rendyhd/movie-time/hardware/output/pdf/Movie_Time_NFC_Sticker_Template_A4.pdf

MOVIE TIME

# NFC sticker starting position

Print on A4 at Actual size / 100%. Do not use Fit to page.

1 Lay the CLOSED case with its BACK COVER facing up. The SPINE must be at the TOP, away from you.

2 Cut out the rectangle below along its solid border.
Put its bottom-left corner on the case's bottom-left corner.

3 Make a tiny hole at the target and mark through it.
Tape the sticker there. If reads fail, move it 5 mm at a time.

BACK COVER UP

SPINE

away from you

26 mm

31 mm

LEFT EDGE

BOTTOM EDGE

Nominal centre:

2.6 cm from the left edge

3.1 cm from the bottom edge

DVD and Blu-ray cases

use the same corner.

The pale circle shows a

25 mm sticker for scale.

Check the print scale with a ruler:

### 50 mm

If this line is not exactly 5 cm, print again at 100% scale.

Fix to the OUTSIDE of the back cover only after 5 reliable insertions.
