rendyhd/movie-time/hardware/output/final_version/preview/01_Spring_PETG_plate.png

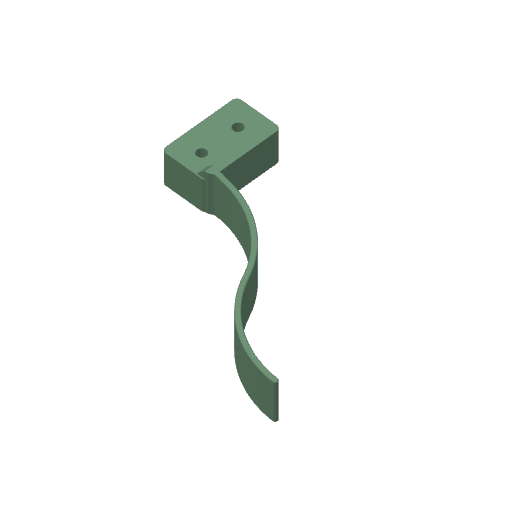
hardware/output/final_version/preview/01_Spring_PETG_plate.png
