rendyhd/movie-time/hardware/output/final_version/preview/02_Cute_Lid_PLA_plate.png

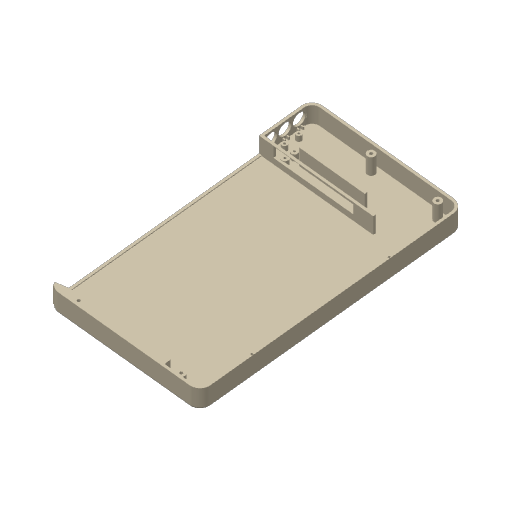
hardware/output/final_version/preview/02_Cute_Lid_PLA_plate.png
