rendyhd/movie-time/hardware/output/final_version/preview/03_Base_PLA_plate.png

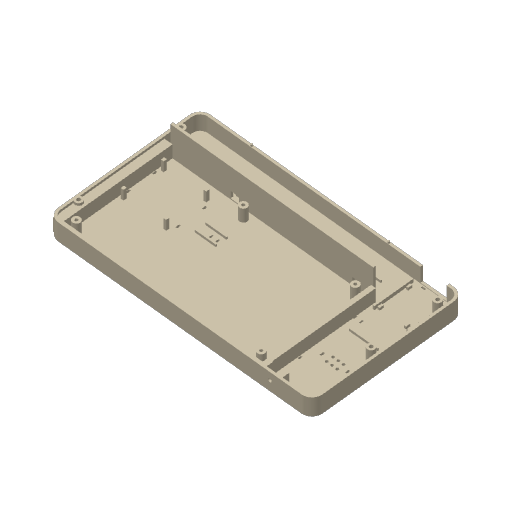
hardware/output/final_version/preview/03_Base_PLA_plate.png
