rendyhd/movie-time/hardware/output/final_version/preview/04_Deck_and_Hardware_PLA_plate.png

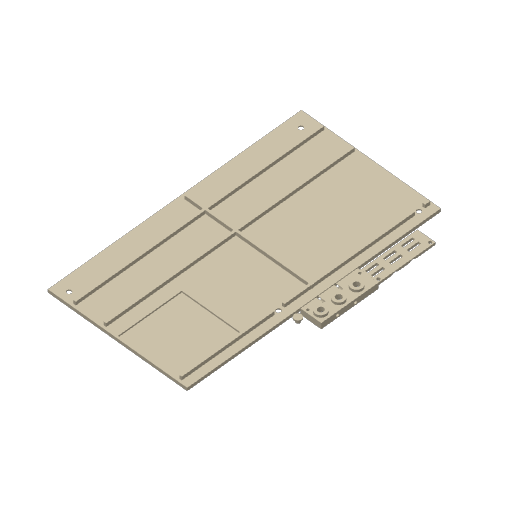
hardware/output/final_version/preview/04_Deck_and_Hardware_PLA_plate.png
