rendyhd/movie-time/hardware/output/final_version/preview/05_Buttons_PLA_plate.png

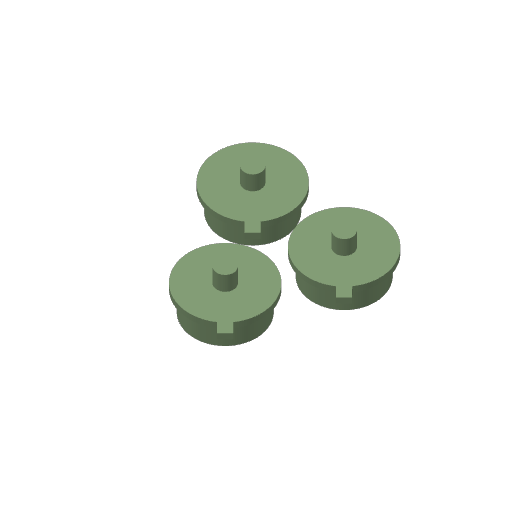
hardware/output/final_version/preview/05_Buttons_PLA_plate.png
