rendyhd/movie-time/hardware/output/final_version/preview/Button_and_case_fit_PLA_plate.png

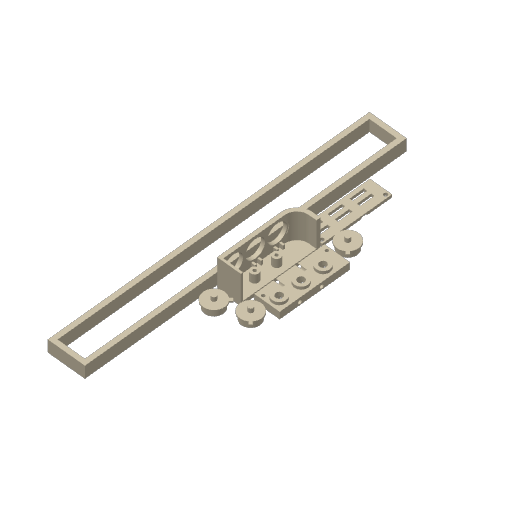
hardware/output/final_version/preview/Button_and_case_fit_PLA_plate.png
