rendyhd/movie-time/hardware/output/final_version/preview/reinforced_joint.png

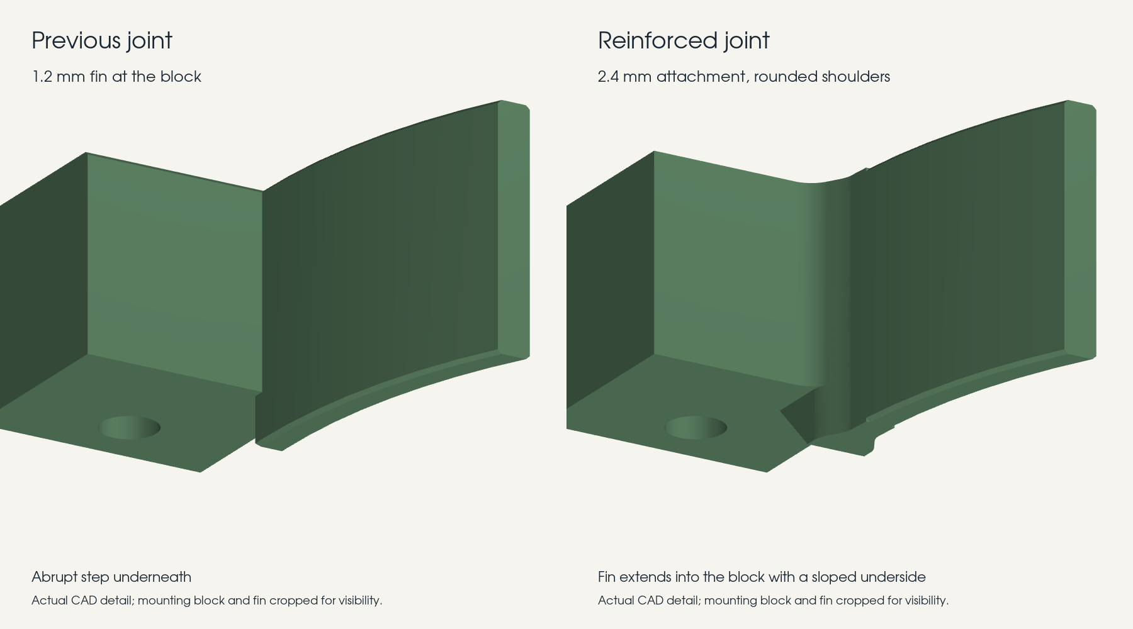
hardware/output/final_version/preview/reinforced_joint.png
