rendyhd/movie-time/hardware/output/final_version/step/Movie_Time_final_assembled.step

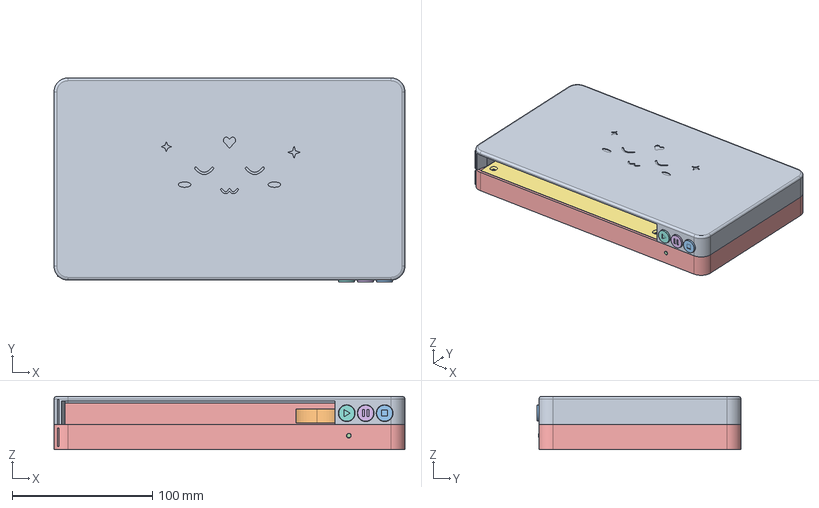
[picture p10: CAD file, 2026-10-13]
hardware/output/final_version/step/Movie_Time_final_assembled.step
250.0 x 145.4 x 38.0 mm
02_cute_lid_single_leaf
08_switch_retainer
06_button_stop
09_led_lens
01_base
05_button_pause
03_case_deck
04_button_play
07_switch_carrier
12_single_leaf_PETG
