rendyhd/movie-time/hardware/output/final_version/optional/Holder_Reach_Fix_PLA.3mf

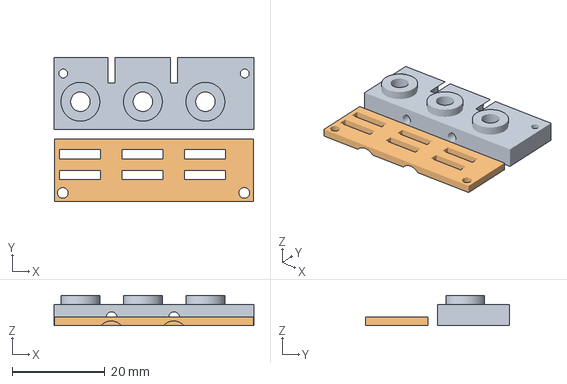
[picture p11: CAD file, 2026-10-13]
hardware/output/final_version/optional/Holder_Reach_Fix_PLA.3mf
43.2 x 31.2 x 6.50 mm
07_switch_carrier.stl
08_switch_retainer.stl
