rendyhd/movie-time/hardware/output/final_version/plates/05_Buttons_PLA.3mf

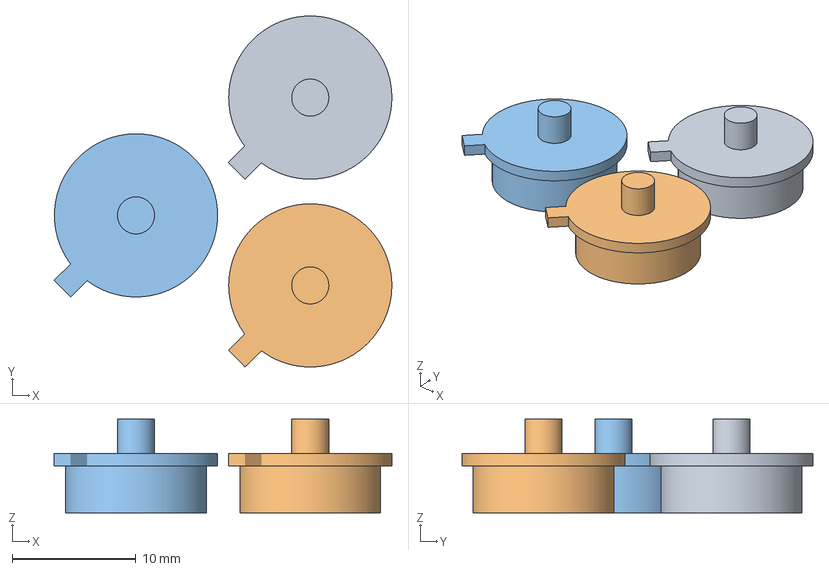
[picture p12: CAD file, 2026-10-13]
hardware/output/final_version/plates/05_Buttons_PLA.3mf
27.3 x 28.4 x 7.60 mm
04_button_play.stl
05_button_pause.stl
06_button_stop.stl
