rendyhd/movie-time/hardware/output/final_version/step/12_single_leaf_PETG.step

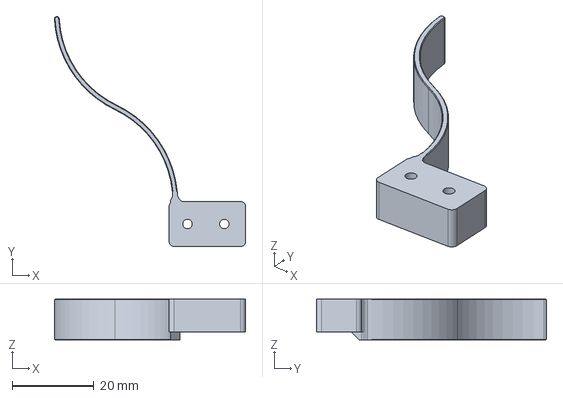
[picture p13: CAD file, 2026-10-13]
hardware/output/final_version/step/12_single_leaf_PETG.step
46.8 x 56.3 x 10.0 mm
