rendyhd/movie-time/hardware/output/final_version/optional/Button_and_case_fit_PLA.3mf

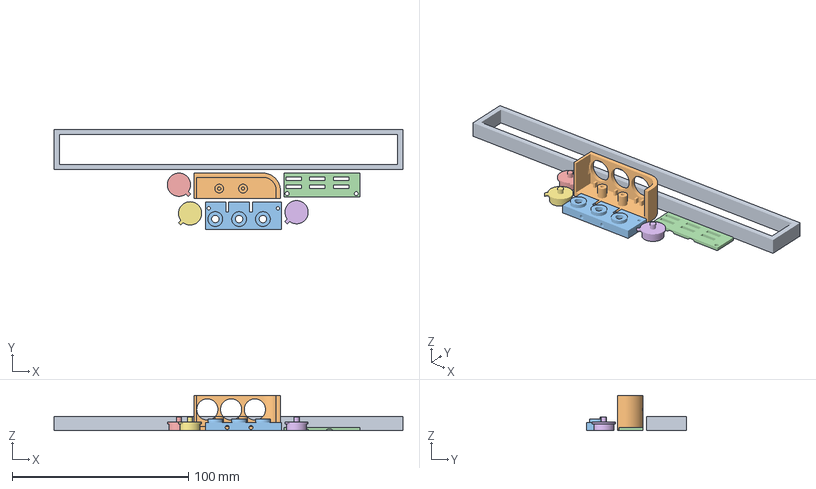
[picture p14: CAD file, 2026-10-13]
hardware/output/final_version/optional/Button_and_case_fit_PLA.3mf
198.0 x 56.9 x 20.0 mm
11_case_fit_test.stl
10_button_fit_test.stl
07_switch_carrier.stl
08_switch_retainer.stl
04_button_play.stl
05_button_pause.stl
06_button_stop.stl
