rendyhd/movie-time/hardware/output/final_version/step/06_button_stop.step

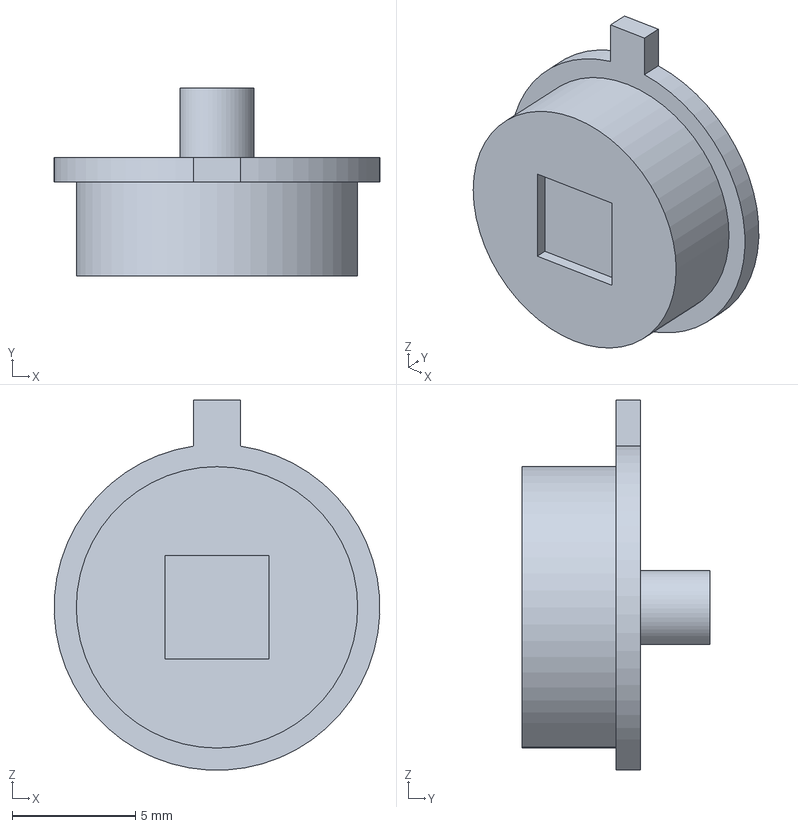
[picture p15: CAD file, 2026-10-13]
hardware/output/final_version/step/06_button_stop.step
13.2 x 7.60 x 15.0 mm
