rendyhd/movie-time/hardware/output/final_version/optional/Spring_test_fixture_PLA.3mf

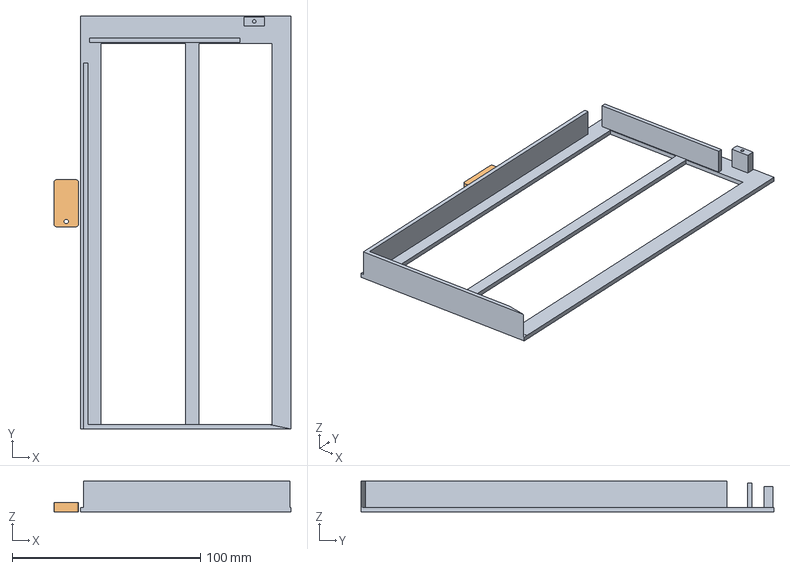
[picture p16: CAD file, 2026-10-13]
hardware/output/final_version/optional/Spring_test_fixture_PLA.3mf
126.0 x 219.4 x 16.4 mm
14_spring_test_bed.stl
15_spring_test_mount.stl
