rendyhd/movie-time/hardware/output/final_version/plates/02_Cute_Lid_PLA.3mf

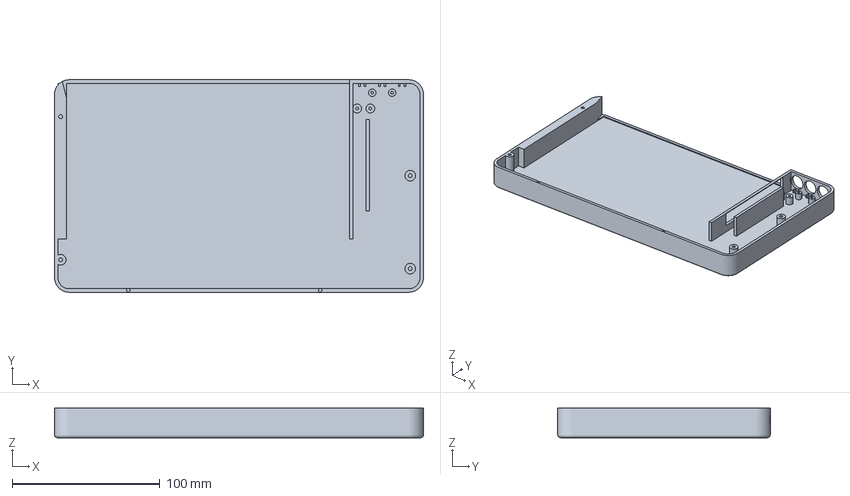
[picture p17: CAD file, 2026-10-13]
hardware/output/final_version/plates/02_Cute_Lid_PLA.3mf
250.0 x 144.0 x 20.0 mm
