rendyhd/movie-time/hardware/output/final_version/plates/03_Base_PLA.3mf

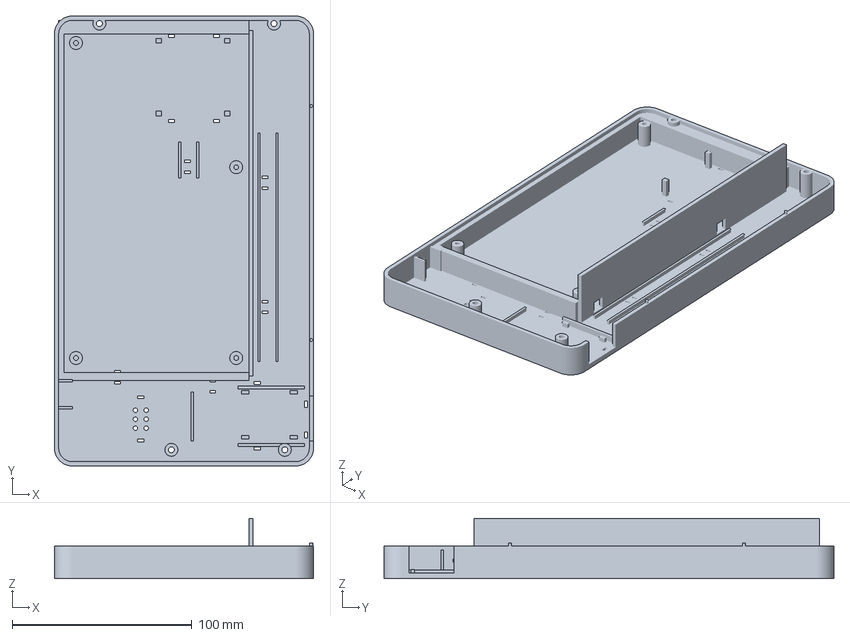
[picture p18: CAD file, 2026-10-13]
hardware/output/final_version/plates/03_Base_PLA.3mf
144.0 x 250.0 x 33.4 mm
