rendyhd/movie-time/hardware/output/final_version/plates/04_Deck_and_Hardware_PLA.3mf

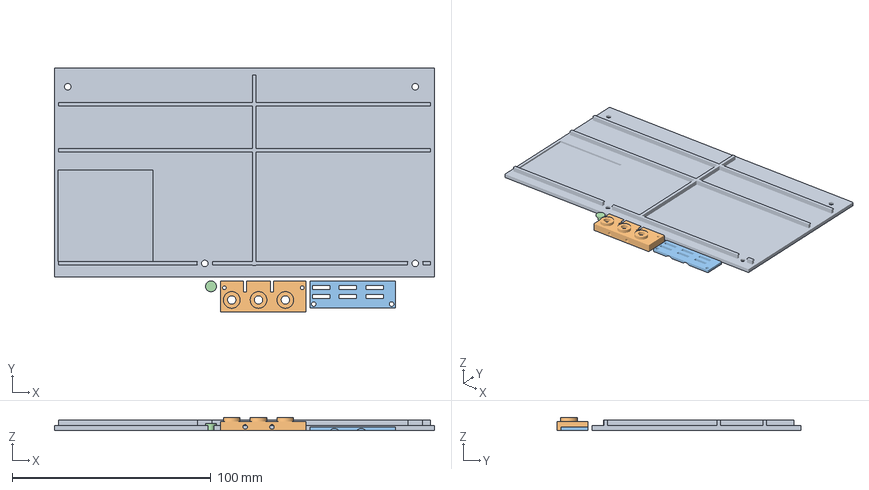
[picture p19: CAD file, 2026-10-13]
hardware/output/final_version/plates/04_Deck_and_Hardware_PLA.3mf
191.4 x 122.7 x 6.50 mm
03_case_deck.stl
07_switch_carrier.stl
08_switch_retainer.stl
09_led_lens.stl
