rendyhd/movie-time/hardware/output/final_version/step/03_case_deck.step

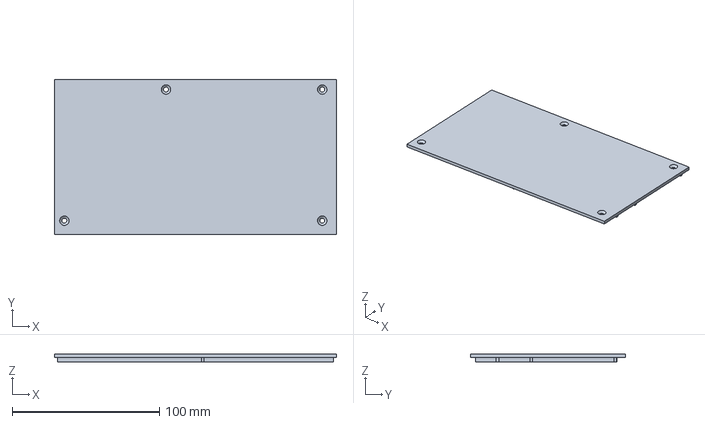
[picture p20: CAD file, 2026-10-13]
hardware/output/final_version/step/03_case_deck.step
191.4 x 105.1 x 5.20 mm
