rendyhd/movie-time/hardware/output/final_version/step/07_switch_carrier.step

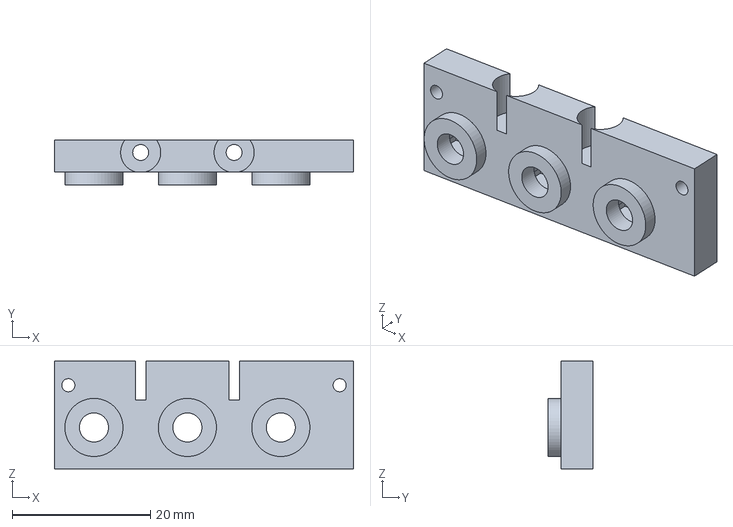
[picture p21: CAD file, 2026-10-13]
hardware/output/final_version/step/07_switch_carrier.step
43.2 x 6.50 x 15.6 mm
