rendyhd/movie-time/hardware/output/final_version/step/09_led_lens.step

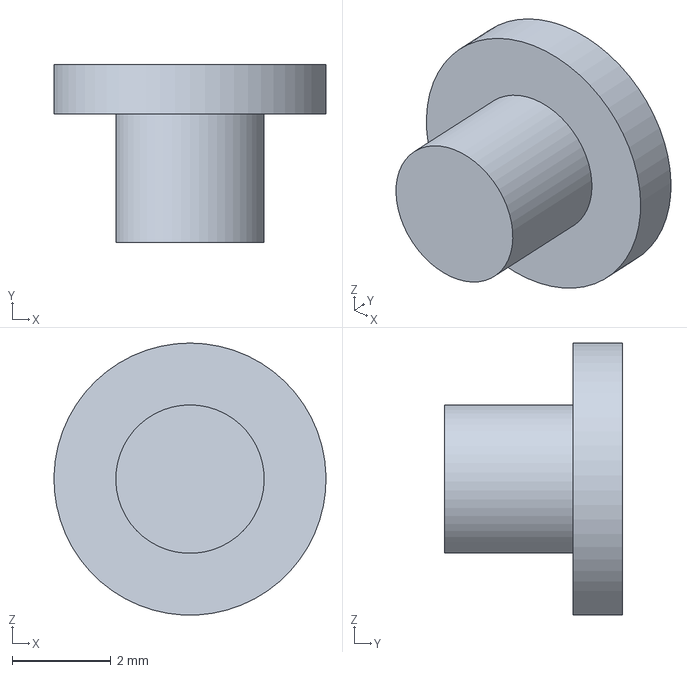
[picture p22: CAD file, 2026-10-13]
hardware/output/final_version/step/09_led_lens.step
5.50 x 3.60 x 5.50 mm
