rendyhd/movie-time/hardware/output/final_version/step/08_switch_retainer.step

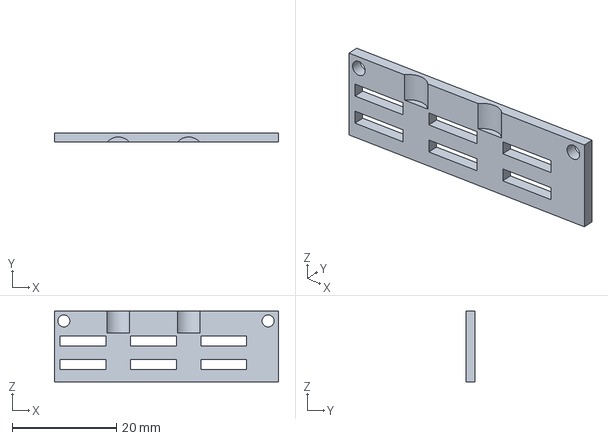
[picture p23: CAD file, 2026-10-13]
hardware/output/final_version/step/08_switch_retainer.step
43.0 x 1.80 x 13.6 mm
