rendyhd/movie-time/(list of files, cad)

Other CAD files:
hardware/output/final_version/plates/01_Spring_PETG.3mf
hardware/output/final_version/step/02_cute_lid_single_leaf.step
hardware/output/final_version/step/01_base.step
hardware/output/final_version/step/04_button_play.step
hardware/output/final_version/step/05_button_pause.step
hardware/output/final_version/stl/01_base.stl
hardware/output/final_version/stl/02_cute_lid_single_leaf.stl
hardware/output/final_version/stl/03_case_deck.stl
hardware/output/final_version/stl/04_button_play.stl
hardware/output/final_version/stl/05_button_pause.stl
hardware/output/final_version/stl/06_button_stop.stl
hardware/output/final_version/stl/07_switch_carrier.stl
hardware/output/final_version/stl/08_switch_retainer.stl
hardware/output/final_version/stl/09_led_lens.stl
hardware/output/final_version/stl/12_single_leaf_PETG.stl
