rendyhd/movie-time/hardware/output/final_version/preview/Holder_Reach_Fix_PLA_plate.png

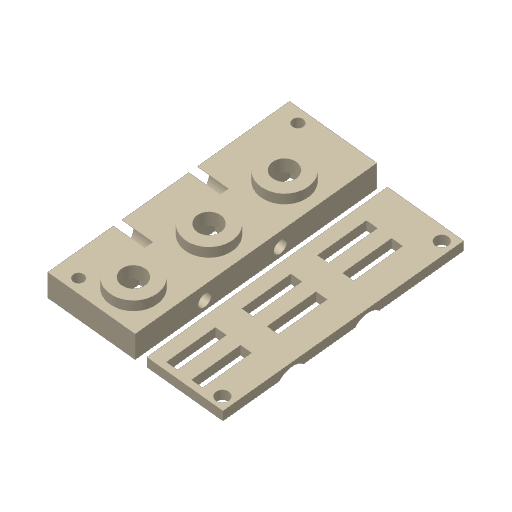
hardware/output/final_version/preview/Holder_Reach_Fix_PLA_plate.png
