rendyhd/movie-time/(commit log)

2026-10-13 Movie Time: NFC case player for Kodi
    An NFC player for a child's DVD/Blu-ray cases. Insert a case to start its
    movie in Kodi through Home Assistant; Play, Pause and Stop buttons work as
    labelled, and removing the case stops playback.
    - ESPHome firmware for an ESP8266 D1 mini with a PN532 reader, WS2812 LED,
    passive buzzer and three buttons (movie-player.yaml, movie_reader.h).
    - Home Assistant blueprint driving Kodi (blueprints/MovieTimeKodi.yaml).
    - Reader unit tests, Home Assistant blueprint tests and a firmware compile
    check in CI.
    - Setup guide, wiring diagram, review notes and validation record.
    Built on Tag Reader for Home Assistant (adonno/tagreader, commit a8bb6fc)
    by Andrea Don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
2026-10-13 Add printed player hardware and refresh README
    Bring the enclosure, PETG case spring, buttons, assembly and wiring guide,
    STEP/STL/3MF print files and CadQuery sources into hardware/.
    The assembly guide's software page now installs movie-player.yaml and the
    Kodi blueprint instead of the superseded movie_buttons.yaml package. The
    wiring diagrams name movie-player.yaml, and docs/movie-time-wiring.png is
    regenerated from the same source.
    Rewrite the README around the whole project: what the player does, how to
    build one, repository layout, wiring and test coverage.
    [01_Spring_PETG.3mf, 01_base.step, 01_base.stl, 02_Cute_Lid_PLA.3mf, 02_cute_lid_single_leaf.step, 02_cute_lid_single_leaf.stl, 03_Base_PLA.3mf, 03_case_deck.step]
